marcelocesarreis/safeboat-vib/relatorios/amarradona-d6-2wk9.html

SAFEBOAT · VIB · ANÁLISE DE VIBRAÇÃO POR ORDENS

# Relatório de Diagnóstico — "AMARRADONA"

AMARRADONA - VOLVO D6 370 I-B HS - S/N 2006011395 - INTERMARINE 380 FULL · sensor na caixa reversora · regimes em NEUTRO (motor isolado de hélice/eixo) · 12 ciclos × 2048 amostras @ ~1651 Hz por regime · gerado em

## 1Severidade global por regime

RMS de velocidade 10–500 Hz (mediana dos 12 ciclos), o número da ISO 20816. A diferença entre os motores explode na lenta e converge no máximo governado — comportamento típico de defeito de injeção (a variação de entrega por cilindro pesa mais quando se injeta pouco).

RMS de velocidade (mm/s) · BE × BB

barras agrupadas por regime · escala linear

BE · boreste (sintoma)BB · bombordo

## 2Espectros — onde a vibração mora

Espectro mediano dos 12 ciclos, eixo dominante, 0–250 Hz. Na lenta, a raia de ~30 Hz do BE é ~8.6× a do BB — mesma frequência, mesmo sensor, mesma fixação (ruído com motor desligado: BE 54.6 × BB 55.1 mg — instalação comparável). A 1200 rpm o BE mostra a raia de meia-ordem 1,5× maior que a própria queima. No máximo, os dois convergem para a banda estrutural comum de 150–210 Hz.

## 3A assinatura: ordens do virabrequim a 1200 rpm

Amplitude nas ordens da rotação (âncoras exatas: BE 1156 · BB 1180 rpm). Num 6 cilindros saudável, a ordem de queima 3× domina e as meias-ordens (0,5× · 1,5× · 2,5×) são residuais — elas só crescem quando um cilindro queima diferente (ciclo de 2 voltas quebra a simetria). No BE, a 1,5× supera a própria queima.

Ordens 0,5×–6× (mg) · 1200 rpm

setas marcam as meias-ordens · Q = ordem de queima (3×)

BEBB

## 4Tendência: a divergência morre com a rotação

Razão BE/BB da severidade em cada regime. É esta curva que aponta injeção e afasta causas mecânicas fixas (desbalanceamento/alinhamento pioram com rotação — aqui é o contrário).

Razão de severidade BE ÷ BB

linha tracejada = paridade (motores iguais)

## 5Dados de suporte

## 6Hipóteses e plano de confirmação

H1 — Injetor/entrega desigual em um cilindro do BE (mais provável). Explica: severidade 8–9× na lenta, meia-ordem 1,5× dominante a 1200, convergência no máximo, e o som "quadrado". Suspeitos na D6: bico com retorno excessivo/agulha gasta; irmão mais caro com a mesma assinatura: compressão desigual.

H2 — Coxim/modo estrutural ~29 Hz no BE (verificar por eliminação). Um apoio degradado poderia amplificar o que cai perto de 29 Hz. Não explica tão bem a meia-ordem a 1200; inspeção visual dos coxins fecha a questão em minutos.

1. Corte de cilindro na lenta (VODIA / balanço de cilindros): ao cortar o cilindro culpado, a vibração quase não muda; nos demais, despenca. Medindo com o VIB durante o teste, o culpado aparece no espectro em tempo real.
2. Trocar o bico do cilindro apontado com o de outro cilindro: se a assinatura acompanhar o bico → bico. Se ficar → medir compressão.
3. Inspecionar coxins do BE (trincas/óleo) para eliminar H2.
4. Repetir a medição VIB após o reparo — o antes/depois vira o primeiro case documentado do produto.

Limitações desta análise: uma gravação por regime/bordo (repetição aumentaria a confiança); sem tacômetro de referência — na lenta, a rotação pode ser lida como ~600 rpm (raia de 29,9 Hz = queima 3×, lenta de fábrica da D6) ou ~900 rpm (raia = 2×); informar o rpm do painel na próxima coleta remove a ambiguidade. O veredito BE ≫ BB não depende dessa escolha. Sensor movido entre motores (não simultâneo) — piso de ruído idêntico com motores desligados valida a comparação.

## 7Referências

· Detection of engine misfire using characteristic harmonics of angular acceleration — ResearchGate 331726855.
· Detection of diesel engine misfire by vibration analysis — ResearchGate 255879989.
· ISO 20816-1:2016 — Mechanical vibration: measurement and evaluation of machine vibration (família p/ máquinas recíprocas: partes 6/8).
· Misfire failure diagnosis of engine based on wavelet analysis — ResearchGate 296912121.
· Randall, R.B. — Vibration-based Condition Monitoring (Wiley, 2011), cap. motores de combustão interna.

SAFEBOAT VIB — sensor LIS3DSH + ESP32-C3 na caixa reversora · análise de ordens executada em ${new Date().getFullYear()} · documento de trabalho de engenharia — confirmar hipóteses pelos testes físicos indicados
