marcelocesarreis/safeboat-vib/stl/base.stl

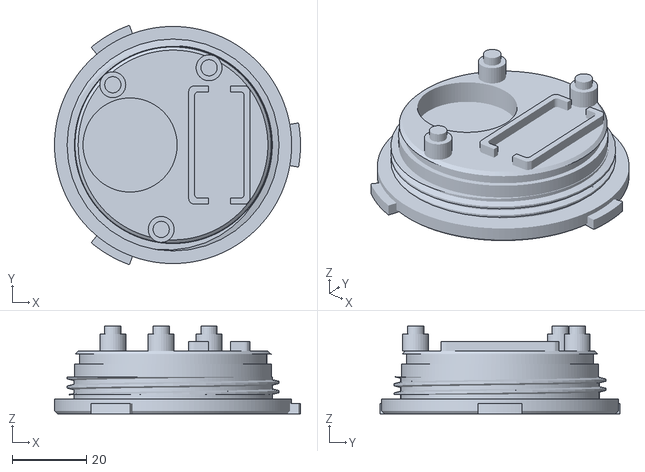
[picture p1: CAD file, 2026-07-20]
stl/base.stl
66.4 x 64.7 x 23.7
