marcelocesarreis/safeboat-vib/stl/corpo.stl

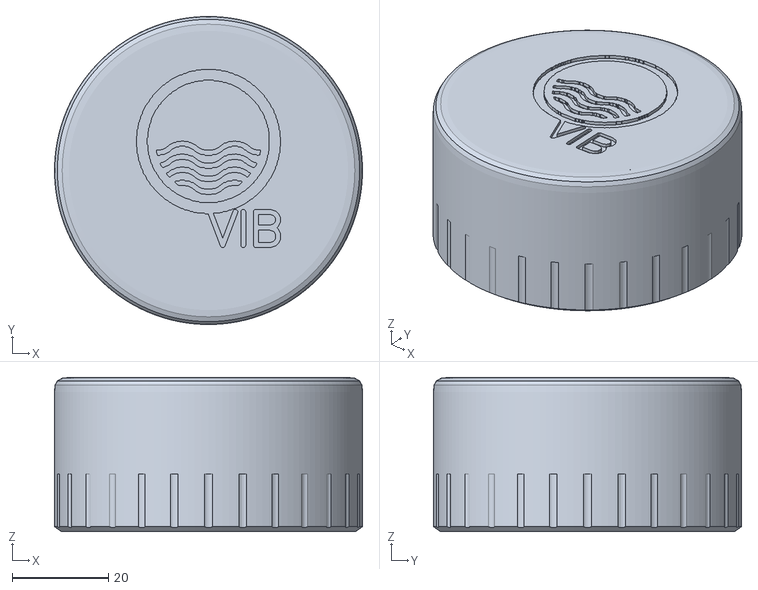
[picture p2: CAD file, 2026-07-20]
stl/corpo.stl
64.0 x 64.0 x 32.0
