marcelocesarreis/safeboat-vib/stl/bandeja.stl

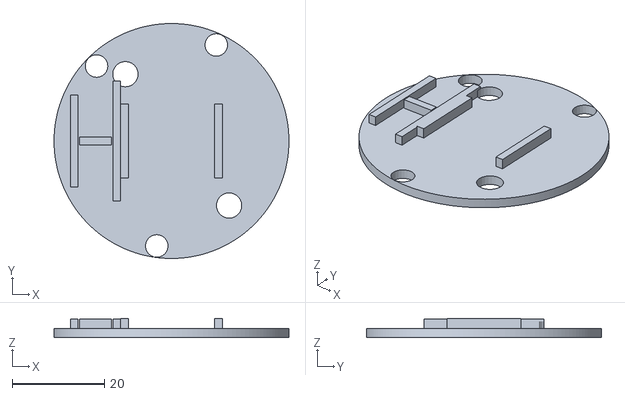
[picture p3: CAD file, 2026-07-20]
stl/bandeja.stl
51.0 x 51.0 x 4.20
