marcelocesarreis/safeboat-vib/stl/berco.stl

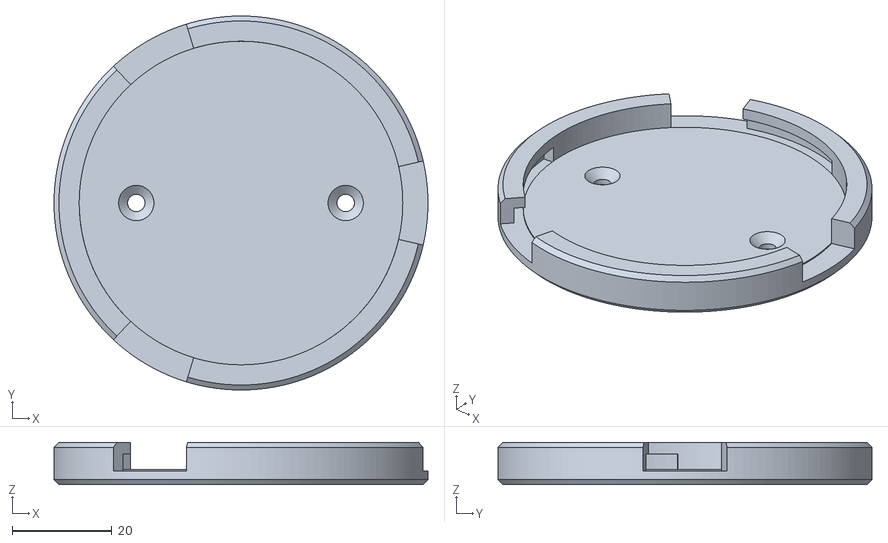
[picture p4: CAD file, 2026-07-18]
stl/berco.stl
75.0 x 75.0 x 8.50
