marcelocesarreis/safeboat-vib/(commit log)

2026-07-16 SAFEBOAT VIB — página do produto: sensor de vibração com cancelamento de mar
    Viewer 3D (Three.js + STLs paramétricos), demo ao vivo da rede de análise,
    projeto elétrico com diagrama, BOM completa do protótipo e seção comercial.
    [bandeja.stl, base.stl, berco.stl, corpo.stl]
2026-07-17 Rev. 2 DFM: paredes reforçadas, O-ring no furo liso, marca SAFEBOAT fiel à arte oficial
    - Barril Ø56 (parede na rosca 2,95 mm; sob as ranhuras 2,65 mm)
    - Berço Ø67 (parede atrás do canal da baioneta 2,75 mm; piso 2,0 mm)
    - Orelhas da baioneta nascem na mesa (imprimem sem suporte)
    - O-ring reposicionado p/ selar no furo liso (antes selava na zona roscada)
    - Plugues no eixo das peças revolucionadas (furo Ø1 vazaria)
    - Marca redesenhada com proporções medidas do PNG oficial
    [bandeja.stl, base.stl, berco.stl, corpo.stl]
2026-07-17 Marca SAFEBOAT vetorizada do PNG oficial na gravação do corpo
    Emblema traçado por marching squares direto da arte (trace-logo.cjs),
    não redesenhado — 6 contornos: anel (com furo) + 4 ondas originais.
    [corpo.stl]
2026-07-17 Berço: escareado dos parafusos aberto na superfície (estava enterrado no piso)
    cylinderElliptic é centrado na posição — o cone ficava em z 0,5–1,5 com
    0,5 mm de material tampando a cabeça. Agora: piso 3 mm, cone 90° de
    z=floor−1,8 a floor+0,2 (cabeça Ø7 flush, alma 1,2 mm).
    [berco.stl]
2026-07-18 Rev. 3: auditoria de encaixe com dimensões reais dos componentes
    CR2477 é Ø24,5×7,7 (não 3,2): célula desce p/ poço na base maciça ao lado
    do LIS3DH. Barril Ø64/furo Ø54 (em Ø46 célula+moldura não coexistem). ESP
    centrado, antena p/ janela livre de metal; banco de rajada vira 2× EDLC
    3,3F/2,7V em série deitados (LIC Ø10×20 não cabia). O-ring 48×2. Postes
    90/225/315. Tabela de auditoria de níveis na página. Sensor Ø64×36.
    [bandeja.stl, base.stl, berco.stl, corpo.stl]
2026-07-20 Rev. 3.1: moldura do LIS3DH refeita para a placa real recebida (12,85 × 28,17 mm)
    Cavidade 13,35 × 28,7 (folga 0,5), eixo longo em Y, aberturas nas paredes
    curtas p/ o header. A moldura de 31,9 mm forçou: postes da bandeja em
    65°/135°/262° e berço dos EDLCs de −Y para −X. Folgas reconferidas
    (poço 3,1 mm; canto da moldura aparado no raio do deck).
    [bandeja.stl, base.stl]
2026-07-20 Rev. 3.2: rosca revisada — impressão travava antes de assentar
    Três causas encontradas na auditoria: (1) boca do corpo Ø56,8 menor que a
    crista macho Ø57,2 — a face colidia com o filete 0,2 mm antes do flange;
    (2) sem alívio de rosca — o filete nascia colado no flange e a boca
    assentava na saída incompleta; (3) folga axial de 0,43 mm insuficiente
    para o inchaço de crista do FDM.
    Correções: boca alargada p/ Ø58,4; alívio de raiz (núcleo liso z4–5,2,
    boca assenta no flange); sulco fêmea ±1,0/±0,5 mais fundo (crista 29,25)
    e filete macho ±0,8/±0,3 → folga axial ~0,7 e radial 0,65; fase
    reconferida (centros fêmea 3,5+2,5k ↔ macho 1+2,5k, seat em z=4);
    ~2 voltas de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
    [base.stl, corpo.stl]
2026-07-21 Firmware de bancada v0.2 + página alinhada ao chip real (LIS3DSH)
    Primeiro firmware do protótipo, testado no hardware real (ESP32-C3
    SuperMini COM3 + placa 12,85×28,17): a placa vendida como LIS3DH
    identificou-se LIS3DSH (WHO_AM_I 0x3F em 0x1D) — 16 bits, 1600 Hz.
    Driver por registrador com autodetecção LIS3DSH/LIS3DH, FIFO stream,
    console serial (info/amostra/stream CSV/rajada 2048+FFT+ISO 10816/
    escala/ODR real). Validado: |g|=1,007, ODR real 1657 Hz, FFT com eixo
    de frequência pela taxa medida, piso de bancada 0,73 mm/s (zona A).
2026-07-21 Monitor de bancada ao vivo: firmware v0.3 (modo monitor JSON) + dashboard SSE
    Firmware entra em modo monitor 4 s após o boot e emite 1 linha JSON por
    ciclo (stats 3 eixos + FFT 256 bins + waveform 256 pts). live-server.cjs
    (porta 8102) faz a ponte COM3→SSE via PowerShell somente-leitura;
    live.html mostra RMS ISO com zona, |g|, forma de onda, espectro com pico
    rotulado e tendência. Testado com dados reais: 1657 Hz, zona A.
2026-07-21 v0.3.1: recuperação de barramento I²C travado
    O monitor parou em bancada: reset do ESP no meio de uma transação I²C
    (reabertura da porta serial ou fio mexido) deixa o LIS3DSH segurando SDA
    baixo — toda leitura vira 0xFF (taxa impossível de 4878 Hz, overrun,
    eixos duplicados). Correções: busClear() com 9 pulsos de SCL + STOP no
    boot; watchdog de sensor no ciclo do monitor (WHO_AM_I errado → destrava
    e re-inicializa, emitindo status); descarte de capturas com taxa >1,5×
    nominal; página mostra as mensagens de recuperação.
    [vib-bench.ino]
2026-07-21 v0.3.2/3: timeout de captura + verificação de config + reconexão automática
    Sequência real de bancada: jumper do sensor afrouxou → módulo perdeu
    alimentação → WHO_AM_I respondia mas CTRL voltou ao padrão (ODR off) →
    captureBurst esperava p/ sempre uma FIFO que nunca enche (firmware
    travado, 'parou de marcar'). Depois o fio soltou de vez e a placa ainda
    ficou presa no bootloader por aberturas de porta com DTR/RTS.
    Correções: captureBurst com timeout de 3×; lisAlive confere identidade E
    configuração (pega sensor que reiniciou); falha de captura → busClear +
    re-init com aviso; chip ausente no boot ou em operação → retry a cada
    2 s com mensagem de jumpers — reencaixo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
2026-07-21 v0.4: FFT movida para o PC — ESP só adquire, análise em resolução cheia
    Firmware despeja a rajada bruta (3 eixos × 2048 int16, ~40 kB JSON) pelo
    USB CDC; o live-server calcula stats dos 3 eixos, FFT 2048 com Hann do
    eixo dominante (0,8 Hz/bin), RMS de velocidade ISO e espectro/onda de 512
    pontos p/ o painel. Ponte serial com buffer de 1 MB e poll de 10 ms para
    as linhas grandes. Modo antigo (FFT no ESP) mantido como referência.
2026-07-21 v0.5/0.6: descoberta de fiação + transporte SPI 3 fios + raio-x elétrico
    Sonda I2C bit-bang (imune a driver travado) varre TODOS os pares de pinos
    expostos da SuperMini x 4 endereços; fallback SPI 3 fios bit-bang nos
    mesmos fios (cobre CS aterrado, que muda o chip p/ modo SPI); raio-x
    elétrico dos pinos (INPUT puro: ALTO = pull-up externo alimentado);
    re-varredura a cada 2 s; ESP.restart() após 5 falhas seguidas; driver
    inteiro roteado por transporte (I2C/SPI) sem mudar a lógica.
    Resultado na bancada: nenhum ACK I2C e nenhum WHO_AM_I SPI em par algum
    de pinos + só os pull-ups de strap da própria SuperMini no raio-x =
    módulo sem alimentação ou chip morto. Painel fica de vigia: re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
2026-07-21 Decomposição dinâmica: separa máquina × movimento × mar num sensor em movimento
    O modelo do produto: acelerômetro numa embarcação navegando mede tudo
    somado. Separação por assinatura física — gravidade (LP 0,4 Hz, vetor g
    rastreado + inclinação), movimento/navegação (0,4–8 Hz), impactos de mar
    (transientes: RMS do sub-bloco >> mediana), máquina (>8 Hz, espectro por
    MEDIANA DE WELCH excluindo janelas com impacto — pancada não vira raia;
    correção ENBW 1,5 da Hann no RMS de velocidade). Firmware v0.7: auto-range
    ±2..±16 g com histerese (o mar decide a escala). Painel novo: gauges
    máquina/movimento/impactos/|g|/qualidade, onda bruta com blocos de impacto
    marcados, on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
2026-07-21 v0.8: escada de transporte de 4 degraus — o link decide a velocidade
    Wire 400 kHz/1600 Hz → 100 kHz/800 → 50 kHz/400 → I2C bit-bang 25 kHz/
    ODR 100 Hz (timing folgado + clock stretching, tolerante a junção
    resistiva). Desce após 2 falhas, sobe após 20 ciclos limpos. Painel
    mostra o degrau atual (I2C kHz). Evidência de bancada que motivou: chip
    dava ACK bit-bang em 8/9 mas Wire não sustentava transação nem a 50 kHz.
2026-07-21 Estado MÁQUINA LIGADA/DESLIGADA no dash
    Classificador por proeminência espectral: raia dominante >4 mg com
    proeminência >8× sobre a mediana do espectro (ou >15 mg absoluto),
    com histerese (liga com 2 ciclos, desliga com 3). Card principal mostra
    o estado com frequência e RPM da raia. Validado ao vivo: vibracall
    reconhecido como MÁQUINA LIGADA · 153 Hz ≈ 9169 rpm.
2026-07-21 Projeto elétrico: pull-ups I²C 2,2 kΩ como requisito de imunidade (campo E)
    Aprendizado de bancada: proximidade do corpo derrubava o barramento —
    acoplamento capacitivo (campo elétrico) em linhas I²C de alta impedância
    com fio voador, não campo magnético (MEMS capacitivo não tem elemento
    magnético). Isolado experimentalmente (sensor na ponta de uma vassoura =
    link estável + decomposição lendo variação espacial). BOM ganha R7/R8
    2,2 kΩ e a seção elétrica a decisão ④: I²C de baixa impedância com
    chicote curto/trançado.
2026-07-21 Gravador de padrões para o teste de mar
    8 padrões operacionais (desligado · neutro 800/1200/máx · engatado
    900/1200/2000/máx) com modelo do motor obrigatório salvo junto. Cada
    gravação = 12 ciclos (~18 s) com BRUTO completo (3×2048 int16 por ciclo,
    p/ reprocessar com algoritmos futuros) + métricas da decomposição, em
    data/padroes/<motor>/<padrao>_<timestamp>.json — nunca sobrescreve.
    UI: grid de botões com estado (não gravado / gravando n/12 / ✓ com hora),
    cancelamento por segundo clique, motor persistido no localStorage.
    Endpoints /rec/start /rec/stop /rec/list. Validado em bancada: arquivo
    de 12 ciclos reais salvo e conferido.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
2026-07-22 Migração p/ notebook: autodetecção da porta COM + logo no layout do repo
    detectCom acha o ESP32-C3 (VID 303A PID 1001) em qualquer COM — no
    notebook a placa não cai necessariamente em COM3; VIB_COM=COMx força.
    Logo do painel resolve tanto public/img (pasta-fonte) quanto img/ na
    raiz (repo clonado).
2026-07-22 Redetecção de COM a cada retry da ponte + listener de saída único
    Plugar o sensor DEPOIS de abrir o painel agora funciona (a ponte
    redetecta a porta a cada tentativa); corrigido acúmulo de listeners
    de exit a cada restart da ponte.
2026-07-22 Segundo motor (BB bombordo) + comparador BB×BE com diagnóstico
    Gravador ganha seletor de bordo (BE boreste / BB bombordo) — arquivos
    <lado>-<padrao>_<stamp>.json, legado conta como BE. Comparador recarrega
    a gravação mais recente de cada bordo p/ o mesmo padrão, reprocessa os
    ciclos brutos, espectro mediano do conjunto, e compara bandas ancoradas
    no 1× DETECTADO de cada lado (lentas nunca são idênticas): 1×=desbalan-
    ceamento/coxim · 2×=desalinhamento · 3–6×=folga · 200–800 Hz=rolamento/
    reversora · lentas ≠ >60 rpm = regular antes de concluir. UI: espectros
    sobrepostos BE (azul) × BB (âmbar), tabela e diagnóstico automático.
    Validado ponta a ponta em simulação (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
2026-07-22 Análise de ordens do teste de mar: diagnóstico de irregularidade de combustão
    Física: em 4 tempos, a ordem de queima (Ncil/2 × rotação) deve dominar;
    meias-ordens (0,5×, 1,5×...) só crescem quando UM cilindro queima
    diferente (injetor/compressão) — o ciclo termodinâmico de 2 voltas
    quebra a simetria. Índices R_half e R_low por bordo/padrão + veredito
    BE×BB. Pente de rotação por ORDENS INTEIRAS (meias-ordens no pente
    degeneram em motor liso — bug pego no teste sintético), piso de
    confiança na queima, relatório HTML com barras de ordem e tabelas.
    Validado: gêmeos sintéticos com/sem meia-ordem → R_half 0,004 × 0,727,
    rpm 797/797, veredito 36× no lado ruim.
    Co-Auth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
2026-07-22 Análise de ordens: faixas realistas de rpm, desambiguação de âncora e transparência
    Faixas de busca por padrão (lenta real de diesel marítimo é 550-700, não
    o rótulo nominal); candidatos ×1/2, ×2, ×2/3, ×3/2 reavaliados com pesos
    planos (pente 1/sqrt-k trava em 3/2 da rotação quando a raia dominante é
    grande); picos dominantes e tabela de ordens 0,5-6x impressos p/ conferir
    âncora na mão. Aplicado aos dados reais da AMARRADONA (Volvo D6-370).
2026-07-22 Gerador do relatório visual de diagnóstico (caso AMARRADONA)
    Recomputa dos brutos e emite HTML standalone: hero tiles, veredito,
    severidade por regime, espectros BE×BB, ordens com meias-ordens
    marcadas, curva da razão por rotação, tabela, hipóteses e plano.
    Paleta BE/BB validada (CVD dE 119). Só a FERRAMENTA vai ao repo —
    o relatório gerado contém dados de cliente e fica local.
2026-07-22 Firmware de campo v1.0: dorme com o motor, transmite sem buracos por Wi-Fi
    Ciclo: deep sleep → farejo periódico (512 amostras, pente de Goertzel
    20–45 Hz) → motor ON → missão: captura gapless (tarefa dedicada drena a
    FIFO em 4 buffers ping-pong enquanto o rádio faz POST chunked /ingest no
    hub, mesmo JSON da bancada) → 60 s sem motor → aviso e hiberna.
    Detector calibrado no teste de mar da AMARRADONA: piso desligado ~62 mg
    espalhado, queima 3x na lenta 600 rpm = 105 mg em ~30 Hz → limiar 25 mg.
    Perda declarada (contador 'lost'), nunca silenciosa. INT1/GPIO3 opcional
    p/ wake por hardware (versão moeda). live-server ganhou POST /ingest:
    sensor Wi-Fi entra no mesmo pipeline e d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
